JakeHafele101/Headnode/README.md

# Headnode

Headnode is in the battery pack and flips the relays to the battery pack as long as we are not in a fault state.
