JakeHafele101/Headnode/Documentation/Head Node Rev 1 Documentation.docx

Head Node

Project (P15) | Current Rev 5 | 7/12/2021 | Si Yuan Sim

HARdware Documentation

Si Yuan Sim

2021

Revision History
Rev # | Description | Hardware Manager | Approved By Need 2/3 for approval: eteam director or assistant director, eteam manager, or alumni
1 | 2021 ASC Rayce, reset for clarity | Si Yuan Sim


# Theory of Operation

## Description

Head node and module boards make up the Battery Protection System. Module boards gather data on pack operation and reports it back to head node. Using this data, array and pack interfaces are controlled. Most of the decision making and control is accomplished through the compute module on head node.

CAN is the primary digital communication protocol used in the car. The compute module CANH and CANL outputs are used for the main CAN bus. The pack network is looped through the modules and is terminated on one side at the end of the module board string. The other terminating resistor is located within Telem. This prevents the need for extra parts or different designs of module boards.

Module boards use a combination of software and hardware monitoring for voltage or temperature faults. The software monitoring and reporting is all handled using CAN as previously discussed. To get hardware fault information back to head node we have added an “Analog_Fault” line connecting each module. This line is normally high and is pulled low by a temperature or voltage fault on any module. The logical state of this line is used for array and pack interface decisions.

Head node is also in charge of the isolation and connection of the pack to the rest of the system that powers the car. Hence, whenever the car is turned on into safe state, to drive or to charge, head node would be responsible for its operation. This is accomplished by having several relay logic circuitry that would turn on the three large relays located within the battery box that are responsible for positive terminal of the pack, negative terminal of the pack and a relay designated for charging. During the turn on sequence, head node also controls the operation of Powerboard which is signified through a digital signal that the battery pack is in a safe state enabling Powerboard to switch from child board to the Vicors to power the critical, main and party lines. During driving, head node also sends a signal enabling Precharge to turn on another larger relay that connects the pack to the motor controllers allowing the motors to be driven.

## Board Placement

Head board will be placed on top of Precharge. They will draw power from Powerboard’s 12V critical line.

## Purpose

Lithium-ion batteries are quite volatile and by competition regulations require complex management systems. PrISUm Solar Car chooses to design and build their own management system over an off the shelf unit.

# Application

## System Level

### Block Diagram


Figure 1 Block diagram

### Pin Diagram

Connector | Connector Type | Pin Number | Connector Function
J1 | 2-Pin Megafit | 1 | Ground
| | 2 | 12V Critical from Powerboard
J2 | 2-Pin Minifit | 1 | Ground
| | 2 | Charge Relay Control
J4 | 2-Pin Minifit | 1 | Ground
| | 2 | Positive Relay Control
J5 | 2-Pin Minifit | 1 | Ground
| | 2 | Negative Relay Control
J3 | 4-Pin Minifit | 1,2 | Ground
| | 3 | Analog Fault Line Start
| | 4 | 12V Critical to Module Board
J13 | 2-Pin Minifit | 1 | Ground
| | 2 | Analog Fault Line End
J7 | 4-Pin Minifit | 1 | 12V Critical
| | 2 | Pack Hall Effect Sensor Reference
| | 3 | Pack Hall Effect Sensor Output
| | 4 | Ground
J9 | 4-Pin Minifit | 1 | 12V Critical
| | 2 | Array Hall Effect Sensor Reference
| | 3 | Array Hall Effect Sensor Output
| | 4 | Ground
J10 | 2-Pin Minifit | 1 | Precharge Drive Signal
| | 2 | Ground
J11 | 2-Pin Minifit | 1 | Powerboard Current Sense
| | 2 | Ground
J17 | 2-Pin Minifit | 1 | Powerboard Pack Start Signal
| | 2 | Ground
J15 | 2-Pin Minifit | 1 | External Kill Switch
| | 2 | Ground
J6, J8 | 2-Pin Minifit | 1 | CAN High
| | 2 | CAN Low
J12 | 4-Pin Minifit | 1,2,4 | Ground
| | 3 | Fan Control
J14 | 6-Pin Minifit | 1 | Array Switch
| | 2 | External Charge Switch
| | 3 | Array Relay
| | 4 | Ground
| | 5 | Tracker Enable
| | 6 | External Charge Enable

### VDR Requirements

5.2.E.3 – Over Temperature Set Points

Battery State | Low(˚C) | High(˚C)
Charge | 10˚C | 45 ˚C
Discharge | -20 ˚C | *60 ˚C

*Monitored by hardware. All others in software

5.2.E.4, 5.2.E.5 – Under and Over Voltage Set Points

Battery Module Voltage Warnings and Limits

Type | Trip Point (Volts) | Hardware Monitored | Software Monitored
Voltage Low Warning | 3.0V | | x
Voltage Low Fault | 2.8V | X | x
Voltage High Warning | 4.0V | | x
Voltage High Fault | 4.2V | X | x

5.2.E.6 – Over Current Set Points

Pack Current Limits for Charge and Discharge

Battery State | Current Limit
Charge | 40.0A
Discharge | -50.0A

5.2.E.8 – Start-up and Fault Handling

When the start process for the car has been initiated by flipping the main switch. The Auxiliary Line will power BPS and critical systems. At this point Head Node will begin polling each individual module through CAN, checking for continuity, voltage measurements and temperature measurements for any faults. If all modules report OK, then the start-up process continues by allowing our Precharge and Powerboard systems to provide power to the rest of the car and close the relays connecting the main pack to the rest of the electrical systems within the car.

The job of every Module Board is to record and report data back to Head Node. When a fault occurs in a battery module, it will be reported by hardware back to a digital kill circuit on Head Node which will open the relays. It will also be recorded by software and reported over the CAN bus to active the BPS strobe and driver fault indicator.

5.2.E.9 – Static Firmware

In order to comply with Regulation 8.4F BPS software must be unmodified after scrutineering and tamper proofing must be implemented. Head node has header pins used to program the microcontroller using JTAG standards. These pins will be covered in taper proof tape and signed by the scrutineer. This will prevent the modification of software on any head node.

5.2.E.10 – Driver Dash and BPS Strobe

The fault CAN message reported by BPS will be picked up by Rear Hal and activate the BPS Strobe. The same message will also be picked up by the driver display and indicates to the driver a BPS fault occurred. When the relays are open HAL, BPS, and Driver Dash are powered by an auxiliary pack.

## Board Level

### Power Supplies

Power for Head node and module boards is supplied by 12V_Crit from Powerboard. This is regulated down to 5V using an NCP1117 linear regulator. This part has the DPAK packaging to handle the thermal load of the large voltage drop. A linear regulator was chosen over a switching type due to the ease of implementation. In the future, a good modification to the board would be to replace this linear regulator. Recom makes integrated modules that are easy to use. For the more ambitious, a custom layout can be done using any switching controller. The regulator is 1A capable, but Head Node only requires ~30mA to operate in normal conditions.

As mentioned above, thermal considerations are an important factor in linear regulator choice. The DPAK version of this part has a maximum Die Junction Temperature of 150C. As can be seen in the following equations, the regulator should comfortably handle the load.

P_d =I_(Load) *(Vin-Vout)=30mA*(12V-5V)=210mW

T_(Rise) =R_(theta) *P_D =(67C)/W*210mW=14.07C

The drawback with this design is the poor efficiency. But it is easy, has only 3 parts, and stays cool so it should not cause any problems. There is also another reference providing a 2.5V reference but this is outdated which was intended for a different hall effect sensor than the one we are using currently.

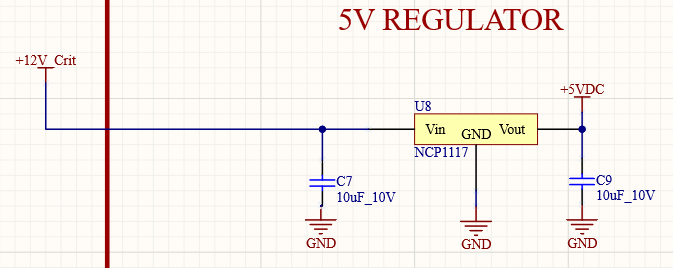
[picture p15: figure]

Figure 2 5V Linear regulator circuitry

### Analog Fault Line

The analog fault line is provided by head node to the first module board in the chain. It is a 5V signal and a jumper resistor was used as a test and can be taken off for future purposes.

Figure 3 Analog fault line start

To receive the analog fault line from the 35th module board, which is the module board at the very end, a buffer circuit is required. This is because the line from the back of the network is very long and there might be considerable losses resulting in a very weak signal. Hence, a BJT was used to buffer it which uses a common collector topology. When the analog fault line is high, it drives the body diode between the base and emitter turning the BJT on. Conversely, it would turn off when the analog fault line goes low. This signal is fed to the MCU as well as the logic interface hardware. This gives us both hardware and software redundancies making the system even safer.

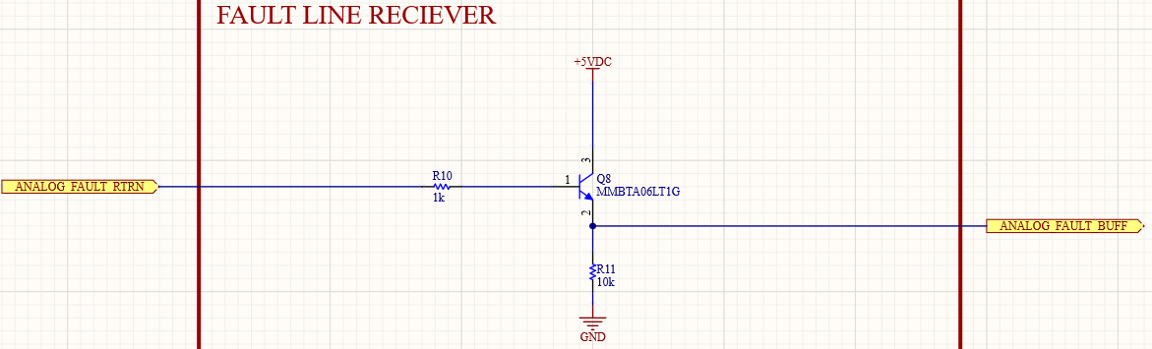
[picture p16: figure]

Figure 4 Analog fault line receive circuit

### External Kill

According to regulations, the car must possess an external kill switch that can be accessed from the outside of the car. This switch should allow for any person to immediately shut down the system and isolate the battery pack in case of an emergency. The switch is connected to a 2-pin minifit connector, and it is typically closed in a normal state. This would pull the uC_EXT_KILL node low giving it a digital signal of 0. To shut down the car immediately, the switch would need to be flipped to the open state causing the node to be pulled up to 5V through a 10kΩ resistor. This was done with the fact in mind that the connectors coming loose would also act as an open switch pulling the node up. It would prevent us from driving without any knowledge that the external kill switch is no longer working.


Figure 5 External kill

### Reverse Polarity and Fuse Blown Circuit

To protect the board from human error if a connector were to be plugged in reverse, a reverse polarity diode is used. This requires a simple P-channel MOSFET where the gate is connected to ground and the source and drain acting as the typical conducting path. In a normal case where the connector is plugged in correctly, the gate would be ground at 0V, and the source would be at 12V. This would have a gate-to-source voltage of -12V turning the MOSFET on thereby powering the entire board. However, if it were to be reversed, the gate-to-source voltage would instead be 12V which would disable the component preventing any other part in the circuit to be destroyed.

The fuse would protect the board from any excessive current draw, and it is set to less than 5A currently due to the current draw from the large relays in the battery box. This might not prevent any components from being destroyed however it would stop it from burning or blowing up as it would cut off the supply. Once again, a P-Fet is used as a good fuse would conduct the 12V to the gate causing the gate-to-source voltage to be 0V turning it off. However, burning the fuse would mean a -12V gate-to-source voltage which would cause the P-Fet to conduct and draw current into a resistor through the 12V supply and current limited by a 1kΩ resistor.

A TVS diode is also used for any high voltage transient suppression (ESD). However, a Zener diode should also be looked into in the future as a clamping mechanism as ESD is typically not as much of a concern for many of our purposes whereas over-voltages happen a lot more regularly within this team.

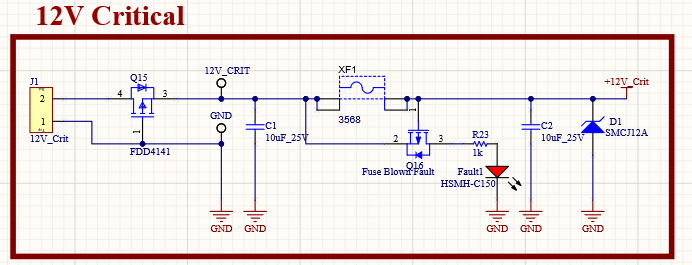
[picture p17: figure]

Figure 6 Reverse protection and fuse blown circuit

### Hardware Interface Logic

The logic that controls much of the operation of head node is located in this circuit. Three AND gates within the same package are used that controls three aspects that are: turning on the car, enabling array charging and enabling external charging. However, external charging has a different implementation, and the current circuit is a leftover remnant from Penumbra’s head node. This includes both circuits in Figure 7 and Figure 8.

For the turn-on operation, three signals are required to turn on the AND gate which produces a high signal (START_EN) that propagates to the three logic circuits that would control the operation of the three large relays within the battery box for positive terminal, negative terminal and external charging. The three signals required are:

1. ANALOG_FAULT_BUFFER – Analog fault line
2. uC_Fault_F – Software controlled fault signal
3. uC_EXT_KILL – External kill switch which defaults to 0 as “good” which is why an inverter is used to turn on the AND gate.

As for the array and external charge logic, as mentioned earlier, this external charge logic is now irrelevant, but the array charge logic remains the same. Similar to the battery pack turn on logic, three signals are also needed, one software fault signal, one hardware and one software switch enable lines for redundancies. They are specifically:

1. uC_Fault_F – Software controlled fault signal
2. ARRAY_EN – Software controlled array enable signal
3. ARRAY_SW – Hardware controlled array enable signal

The output of this AND gate signal for arrays would then be XORed with the same exact logic circuit for external circuit (not in use). This means that if the ARRAY_TRIGGER signal were to be high, array charging will always be enabled since this external charge logic is disabled. Hence, in order to ensure that both external charge and arrays are not enabled at the same time (since external charge is controlled in a separate logic), software has to be written in order to ensure that only one of the functions are on at the same time.

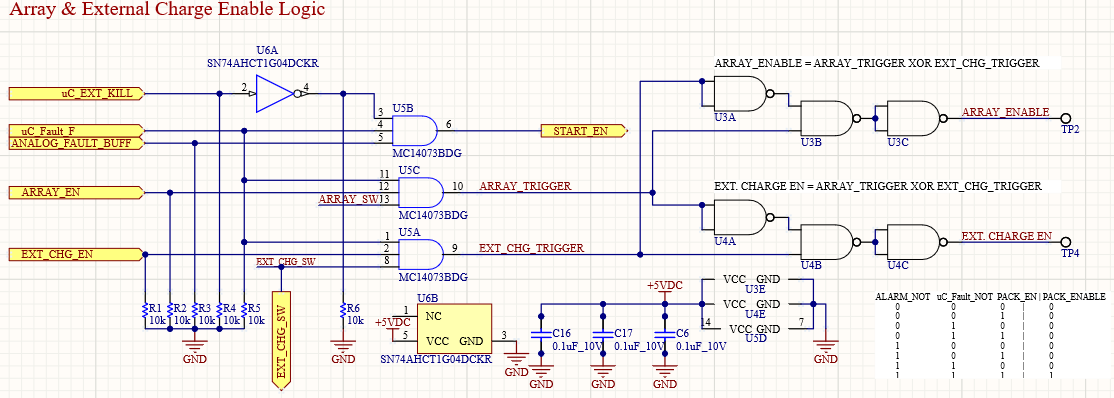
[picture p18: figure]

Figure 7 Hardware interface logic

### Array Interface

As mentioned earlier, the external charging interface here is outdated but is still in use for arrays. The two MOS circuits on the right are the switch circuits that lead to the AND gate logic earlier. N-channel MOSFETs are used since if the switch were closed and connected to ground, that would mean the device is turned off and connected to ground propagating a high signal. Conversely, if the switch were to be opened, the gate is connected up to 5V turning the device on and connecting the ARRAY_SW node to ground. This has similar intent to the external kill logic since a disconnecting connector would not artificially induce a high signal but instead kill the entire charging operation which would alert users appropriately.

The circuits on the left side on the figure instead are used to control signals that are sent out of the board to their respectively destinations. After fulfilling all the conditions necessary, the N-channel MOSFETs are turned on causing them to propagate a low signal.


Figure 8 Array and external charge interface

### Relay Logic

The large relays within the battery box that are not installed on any battery box are driven by the control relay logic housed on head node. There are two stages that control its operation. The first stage is a two input AND gate that turns on either a relay or a power switch that is used to drive the larger off board relays (Figure 9). For this revision, the semiconductor shortage prevented us from obtaining the power switches hence for the car, Eliana, the primary way of turning the large relays will be through the smaller onboard relays. A 0Ω jumper resistor is used to switch between the two methods of driving and only one method should be used at any given moment. This is to prevent any conflicts between the two electrical components as one could be shunting current into the other thereby burning both components.

The second stage involves either using a relay to shunt current into the larger relay or through a power switch. We will be explaining the relay method first in Figure 10. There is a need to buffer the 5V digital signal from the two input AND gate to 12V as the linear regulator used on head node is not sufficient to supply both the smaller relay and the large relay. The onboard relays are OMRON G5CA-1A 12V which means it has a 12V coil rating. Theoretically, we should be able to just use a 5V control signal to turn on a relay to shunt 12V to the larger relays, however through extensive testing, it was found that the MOSFET that allows for current to flow into the coil of the current tends to burn which shows that more current is being drawn than expected. The same is true for the large relays which have a peak instantaneous current draw of 3A. Hence, both the large and small relays are being drawn of 12V Critical from Powerboard which has such capabilities. The buffer circuit works through this process:

1. If the gate voltage of Q6 (or Q10 and Q12) is 5V, it will cause the gate of Q9 (or Q11 and Q13) to be pulled to ground turning it on.
2. This means that current would flow through the coil of the OMRON relay which will generate a magnetic field pulling the contacts shut.
3. Current is shunted directly from 12V Critical to the large off board relays.
4. The opposite happens is the digital input at the beginning

Note the use of the diode that is connected across the coil of each OMRON relay. This is a flyback diode which is used to discharge the energy stored in the coil (acting as an inductor). This prevents any reverse voltage across the P-channel MOSFET which would damage it and cause unexpected behaviors.


Figure 9 Control logic to turn on onboard relays

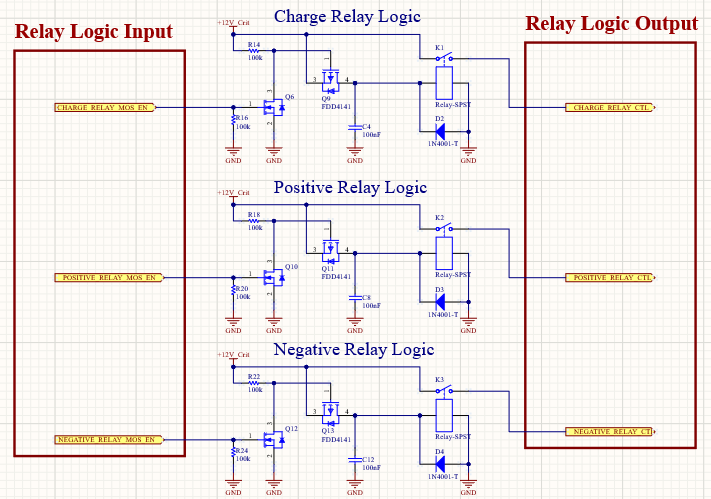
[picture p19: figure]

Figure 10 Relays to turn on larger battery box relays

### Current Sense

Another aspect of head node is sensing the current that is flowing from the arrays into the pack as well as the current that is being used by the motor controllers to power the motors. To achieve this, hall effect sensors from Honeywell are used, CSLA2DG. These sensors can sense both AC and DC current which is ideal since regen would also send power back to the pack which would be useful information to obtain. They also run on 12V Critical supplied by head node and output 6V at 0A nominally. However, it was found that there are quite large differences between different components, and they need to be characterized in order to have an accurate read.

The characterization process includes looping a wire around the hall effect sensor multiple times in order to artificially generate a larger magnetic field which we can translate into a large current. This is because the bench power supplies can only generally reach up to 5A and it is an easy way to know the current flowing through the wire. Through testing, it was found that a looping a wire around just once would double the “current” compared to a straight wire just going through the middle of the hall effect. Hence the equation to generalize the current would be:

Theoretical output current=(Number of loops+1)*Actual supply current

The characterization for one of the hall effect sensor used can be found in Figure 11 and it can be seen that it is extremely linear. But the downside of this hall effect sensor is that its maximum current sense is at 150A which is double our maximum expected output at 80A. This means that we would be unable to full advantage of the resolution of the ADC on the MCU on S+. This was caused by a lack of supply for the other models. Another note is that there is a need to subdivide down the output voltage from 12V (max) to 5V (MCU voltage) to prevent burning an S+. This was accomplished by a simple voltage divider with a ratio of 5/12.


Figure 11 Linear regression model of hall effect sensor

### Precharge and Powerboard Interface

Precharge and powerboard propagate a signal from the MCU on compute which is then buffered using two different circuits. Powerboard requires a 12V signal hence the same circuit used on the previous relay buffer is also used here and it operates the same. The precharge buffer on the other hand uses a BJT in a common collector configuration. A high signal drives the body diode of the BJT between the base and emitter turning the component on drawing current from the collector to the emitter which would drive the signal across a wire to precharge which is located below head node.

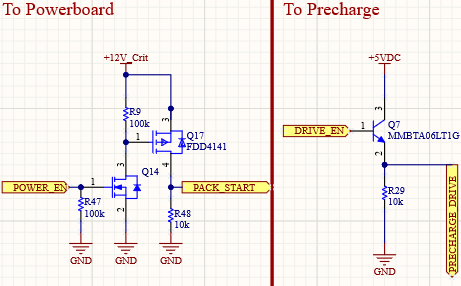
[picture p20: figure]

Figure 12 Precharge and powerboard interface

### Power Switches

The power switches from Infineon were not able to be ordered hence it could not be tested. However, the part was very simple according to its datasheet with no decoupling necessary and only a 10kΩ current limiting resistor was required to turn on at the enable line. This would protect the MCU during overvoltage and during reverse battery condition. The current sense was also going to be ignored on this board since there is a limit on the number of analog input pins and there is no big need to measure these currents. But the resistor values used were suggested by the manufacturer. The output current is determined the sense resistor which is 1kΩ with the 10kΩ resistor being used for protection. The current sense output would be a current which is determined using the equation below.

I_(IS) =((I_L)/(k_(IS)))+I_(IS(OFFSET))

k_(IS) =(I_(L1) -I_(L2))/(I_(IS) (I_(L1) )-I_(IS) (I_(L2) ))

I_(IS(OFFSET)) =50uA min, 240uA typical and 600uA max


Figure 13 Power switches to turn on large off board relays

### PCB Picture

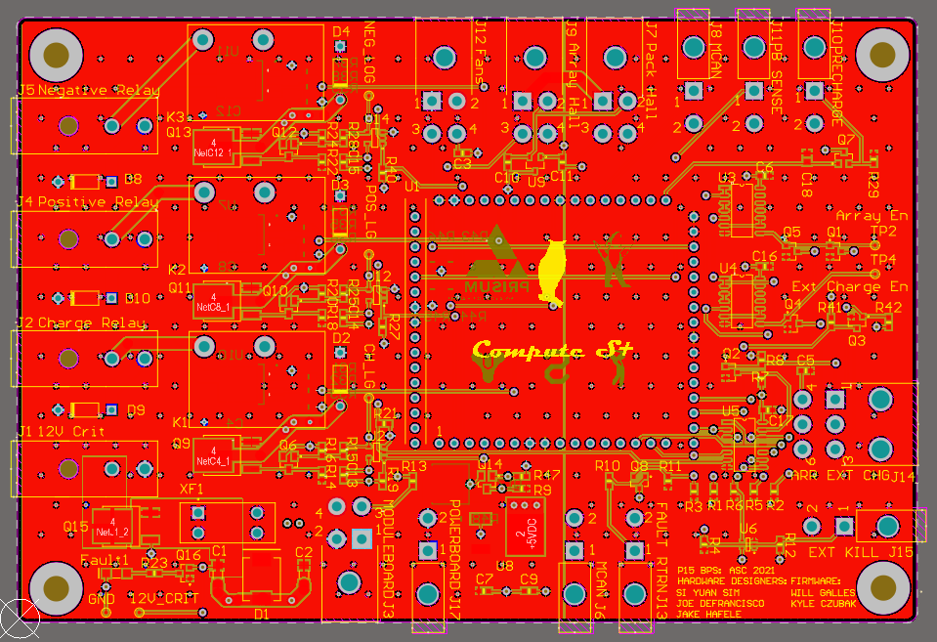
[picture p21: figure]

Figure 14 PCB layout of head node

Head node was laid out with the intention to divide the PCB into two parts to accommodate a 12V domain (left) and a 5V digital domain (right). It also uses four layers with the middle two layers being a 5V plane and a solid intact ground plane. The top and bottom layer for the left side (12V domain) is a 12V plane which is stitched together using stitching vias which would allow for maximum current to be shunted to the necessary outputs. This left side basically consists of the relays as well as its supporting logic to turn them on.

The right side on the other hand consists of all the digital logic operating at 5V. This includes the hardware interfacing logic as well as the other circuits operating at 5V. The bottom and top layers are covered by a ground plane which would isolate the noise produced by digital circuits during high speed switching.

# Proof of Operation

## Test Procedure

1. Test 12V and 5V rails
  a. Connect J1 to a 12V source and measure the test point 12V_Crit to check if power propagated across the fuse.
  b. Check the right large tab on U8 and ensure that it is outputting 5V.
2. Check turn on logic
  a. Provide 5V to pin 1 of J13 which is the analog fault return line.
  b. Short J15 (external kill) across each other to ground.
  c. Provide 5V to the pin PA13 at the compute using a supply.
  d. Measure pin 6 of U5 (second from bottom left) and ensure it is high at 5V.
  e. Remove each of the above inputs and check pin 6 once again and ensure that it turns low.
3. Check turn on for relays
  a. Keep the above signals high
  b. Provide 5V to PA9, PA10 and PA11 each and wait for a click sound from the relay which symbolizes that the contacts closed
  c. Otherwise, check the test points CH_LG, POS_LG and NEG_LG and check if they went high
  d. If they went high and no clicking sounds can be heard from the relays, there is most likely an issue with the buffer.
  e. If they went low instead, there might be an issue with the AND gate.
4. Check output buffers for Powerboard and Precharge
  a. For precharge, give pin PA27 on the compute pin 5V and check pin 1 of J10 and check for 5V.
  b. For powerboard, give pin PB10 on the compute pin 5V and check pin 1 of J17 and check for 12V.
  c. In either case, if both are not giving the expected outputs, ensure that the correct MOSFETs are used with the correct type.

## Test Results

The board works as intended accordingly as explained in the project details.

## Troubleshooting

1. A common issue found was that the digital logic gates were easily overloaded if too small values of pulldown resistors were used. This would draw out too much current from the AND gates preventing a strong pull to the 5V rails for a high signal.
2. Due to the mix match of transistors used in this circuit, if anything is behaving unexpectedly, it would be significantly easier to isolate the cause to a particular circuit and start unsoldering one transistor after another and testing if the remaining transistor on board works. It is unadvised to reuse transistors.
3. If it is suspected wrong transistors were put on, it is much easier to just put on a new one that it is known that it is of the correct type as it is hard to attempt to figure the type of transistor as well as its chemistry.

## Future Considerations

1. The power switches should replace the relay circuitry as the relay circuitry uses a constant 16mA each for a total of 48mA when all three are turned on just to run these small onboard relays. Using the power switches would reduce the power expenditure to only the large offboard relays which is unavoidable. This would further increase the efficiency of the car.
2. Remove old external charging interface in the Interface schematic page as it is outdated. Think of hardware redundancy to prevent both the turn on of array and external charging. Could use XOR gate circuit which is pretty straight forward.

# Additional Resources

## PrISUm Contacts

Name | ISU Email | Personal Email | Phone
Si Yuan Sim | simsy@iastate.edu | simsiyuan@gmail.com | 515-2008140
Joe DeFrancisco | joedef@iastate.edu | - | 515-8228289

# Appendix

## BOM List

Check the P15_BPS repository in Prisum’s Github account.
