JakeHafele101/Headnode/BOM/BPS_REV2_BOM.xlsx

General Part | PCB Label | Custom Reference | Manufacturer Number | Retailer Number | Package Size | Value | Retailer Link | Amount Per Board | Cost per unit | Amount Per Order | Cost Per Order Per Part | Board Name: | Headnode
12V Zener | D1 | Headnode D1 | SMCJ12A | SMCJ12ALFCT-ND |  |  | https://www.digikey.com/en/products/detail/littelfuse-inc/SMCJ12A/762376 | 2 | $0.58 | 6 | $3.48 | Number of Boards: | 3
Rectifier Diode | D2, D3, D4, D5 | Headnode D2, D3, D4, D5 | 1N4001-T | 1N4001DICT-ND |  |  | https://www.digikey.com/en/products/detail/diodes-incorporated/1N4001-T/601 | 5 | $0.58 | 15 | $8.70
Red LED | Fault1 | Headnode Fault1 | HSMH-C150 | 516-1439-1-ND | 1206 |  | https://www.digikey.com/en/products/detail/broadcom-limited/HSMH-C150/637700 | 2 | $0.48 | 6 | $2.88 | Total cost: | $209.19
10 uF 16V Cap | C1 | Headnode C1 | CL31A106MOHNNNE | 1276-2877-2-ND | 1206 | 10 uF 16V | https://www.digikey.com/en/products/detail/samsung-electro-mechanics/CL31A106MOHNNNE/3888535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 | 2 | $0.28 | 6 | $1.68
1 uF 16V Cap | C2 | Headnode C2 | CL31F105ZOCNNNC | 1276-2857-2-ND | 1206 | 1 uF 16V | https://www.digikey.com/en/products/detail/samsung-electro-mechanics/CL31F105ZOCNNNC/3888515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 | 2 | $0.00 | 6 | $0.00
0.1 uF 50V Cap | C9 | Headnode C9 | 08055C104JAT2A | 478-3352-2-ND | 805 | 0.1 uF 50V | https://www.digikey.com/en/products/detail/kyocera-avx/08055C104JAT2A/929984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 | 2 | $0.18 | 6 | $1.08
10 nF 100V Cap | C3, C5, C6, C7, C10, C11, C13, C14, C15, C16, C17 | Headnode C3, C5, C6, C7, C10, C11, C13, C14, C15, C16, C17 | CGA3E2X8R2A103K080AD | 445-8825-2-ND | 603 | 10 nF 100V | https://www.digikey.com/en/products/detail/tdk-corporation/CGA3E2X8R2A103K080AD/3248155 | 15 | $0.25 | 45 | $11.25
10 pF 50V Cap | C8, C12 | Headnode C8, C12 | C0805C100G5GACTU | 399-C0805C100G5GAC7800TR-ND | 805 | 10 pF 50V | https://www.digikey.com/en/products/detail/kemet/C0805C100G5GAC7800/12701157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 | 3 | $0.00 | 9 | $0.00
Inverter | U6 | Headnode U6 | SN74AHCT1G04DCKR | 296-4706-1-ND |  |  | https://www.digikey.com/en/products/detail/texas-instruments/SN74AHCT1G04DCKR/376059 | 2 | $0.38 | 6 | $2.28
3 Channel 3 Input AND | U4, U5 | Headnode U4, U5 | MC14073BDG | MC14073BDGOS-ND |  |  | https://www.digikey.com/en/products/detail/on-semiconductor/MC14073BDG/1478796 | 3 | $0.46 | 9 | $4.14
Quad Channel 2 Input NAND | U3 | Headnode U3 | 74AC00SCX | 74AC00SCXCT-ND |  |  | http://www.digikey.com/product-detail/en/fairchild-semiconductor/74AC00SCX/74AC00SCXCT-ND/1626130 | 2 | $0.63 | 6 | $3.78
PMOS | Q15 | Headnode Q15 | FDD4141 | FDD4141CT-ND |  |  | https://www.digikey.com/en/products/detail/on-semiconductor/FDD4141/1658354 | 2 | $1.05 | 6 | $6.30
NMOS | Q1, Q2, Q3, Q4, Q5, Q6 | Headnode Q1, Q2, Q3, Q4, Q5, Q6 | MGSF1N03LT1G | MGSF1N03LT1GOSCT-ND |  |  | https://www.digikey.com/en/products/detail/on-semiconductor/MGSF1N03LT1G/919443 | 10 | $0.47 | 30 | $14.10
PMOS | Q16 | Headnode Q16 | IRLML6402TRPBF | IRLML6402PbF |  |  | https://www.digikey.com/en/products/detail/infineon-technologies/IRLML6402TRPBF/811437 | 2 | $0.55 | 6 | $3.30
High Side Switch | U7, U10, U11 | Headnode U7, U10, U11 | BTF500601TEAAUMA1 | BTF500601TEAAUMA1TR-ND |  |  | https://www.digikey.com/en/products/detail/infineon-technologies/BTF500601TEAAUMA1/2523005 | 3 | $4.81 | 9 | $43.29
1k Res | R10, R12, R33, R36, R39 | Headnode R10, R12, R33, R36, R39 | RC0603FR-071KL | 311-1.00KHRCT-ND | 603 | 1k | https://www.digikey.com/en/products/detail/yageo/RC0603FR-071KL/726843 | 10 | $0.10 | 30 | $3.00
10k Res | R1, R2, R3, R4, R5, R6, R7, R8, R9, R11, R12, R14, R15, R16, R17, R18 R19, R21, R27, R31, R32, R34, R35, R37, R38, R40 | Headnode R1, R2, R3, R4, R5, R6, R7, R8, R9, R11, R12, R14, R15, R16, R17, R18 R19, R21, R27, R31, R32, R34, R35, R37, R38, R40 | RC0603FR-0710KL | 311-10.0KHRCT-ND | 603 | 10k | https://www.digikey.com/en/products/detail/yageo/RC0603FR-0710KL/726880 | 40 | $0.10 | 120 | $12.00
Ferrite Bead | FB1 | Headnode FB1 | HI1206N800R-10 | 240-2409-2-ND | 1206 | 80 Ohm | https://www.digikey.com/en/products/detail/laird-signal-integrity-products/HI1206N800R-10/806646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 | 3 | $0.10 | 9 | $0.90
5V Switching Reg | U2 | Headnode U2 | R-78AA5.0-1.0SMD-R | 945-1044-2-ND |  |  | https://www.digikey.com/en/products/detail/recom-power/R-78AA5-0-1-0SMD-R/2256224 | 1 | $9.84 | 3 | $29.52
2 Pin Minifit | J6, J8, J10, J11, J13, J15, J17 | Headnode J6, J8, J10, J11, J13, J15, J17 | 39300020 | WM21351-ND |  |  | https://www.digikey.com/en/products/detail/molex/0039300020/930320?s=N4IgTCBcDaIAxwMwE5ELmOIC6BfIA | 10 | $0.66 | 30 | $19.80
4 pin Minifit | J3, J7, J9, J12 | Headnode J3, J7, J9, J12 | 39301040 | WM1352-ND |  |  | https://www.digikey.com/en/products/detail/molex/0039301040/561079 | 5 | $0.75 | 15 | $11.25
6 Pin Minifit | J14 | Headnode J14 | 39301060 | WM1352-ND |  |  | https://www.digikey.com/en/products/detail/molex/0039301040/561079?s=N4IgTCBcDaIOoFkCMBmArGAtAOQCIgF0BfIA | 2 | $0.85 | 6 | $5.10
2 Pin Megafit | J2, J4, J5 | Headnode J2, J4, J5 | 768250002 | WM11969-ND |  |  | https://www.digikey.lt/product-detail/en/molex/0768250002/WM11969-ND/5639611 | 4 | $1.14 | 12 | $13.68
Blade Fuse Holder | F1 | Headnode F1 | 3568 | 36-3568-ND |  |  | https://www.digikey.com/en/products/detail/keystone-electronics/3568/2137306 | 2 | $1.28 | 6 | $7.68
