JakeHafele101/Headnode/Altium Project/Headnode.pdf

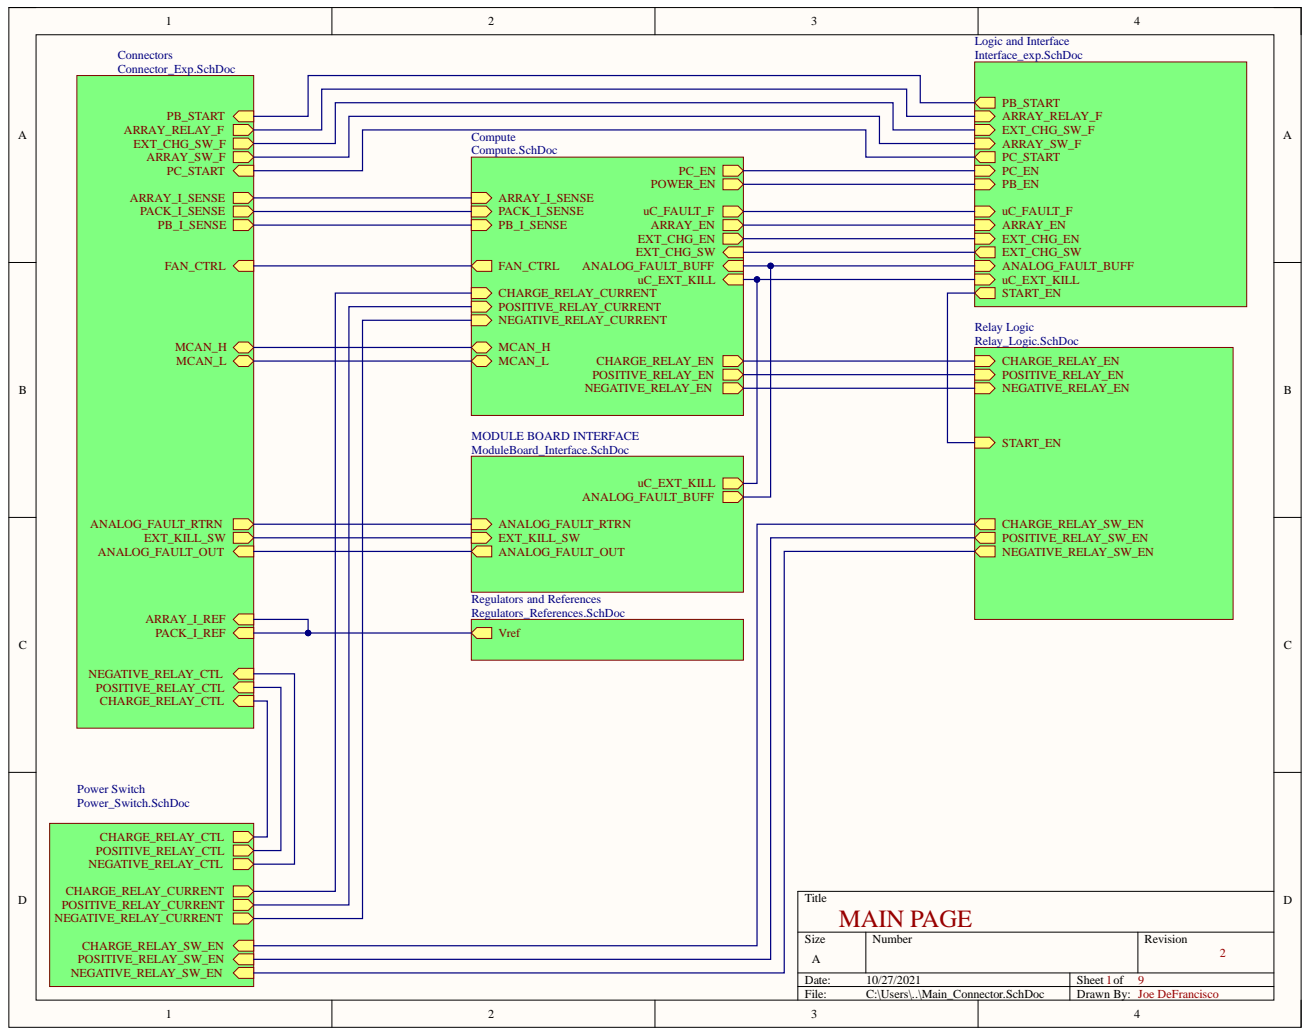
[picture p22: page 1]

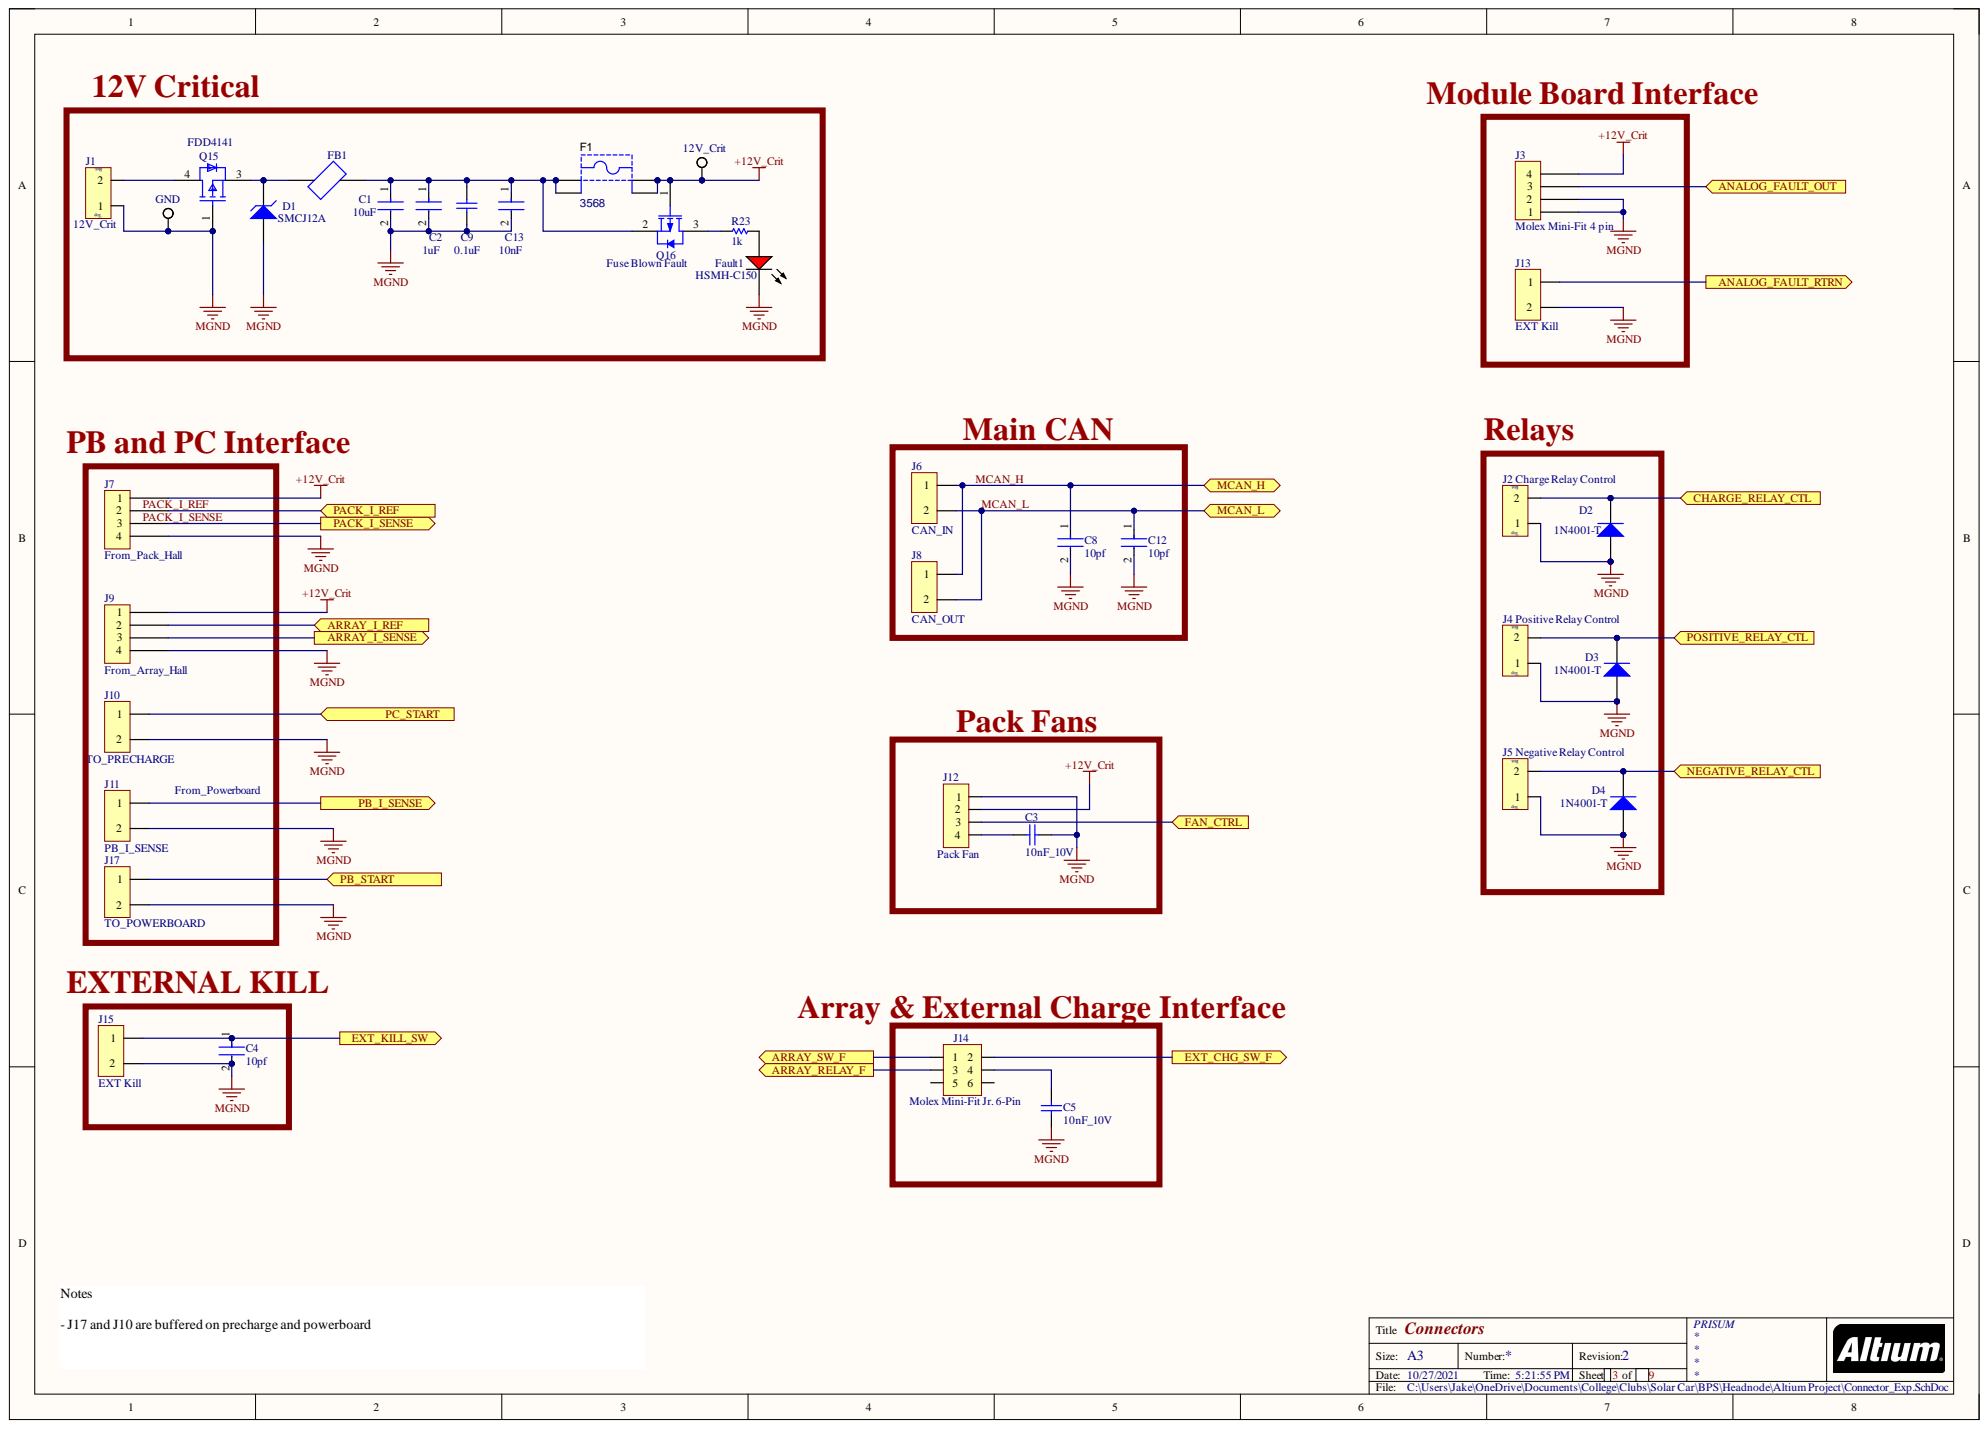
[picture p23: page 2]

PB and PC Interface

Array & External Charge Interface

Molex Mini-Fit Jr. 6-Pin

-J17 and J10 are buffered on precharge and powerboard

C:\Users\Jake\OneDrive\Documents\College\Clubs\Solar Car\BPS\Headnode\Altium Project\Connector_Exp.SchDoc

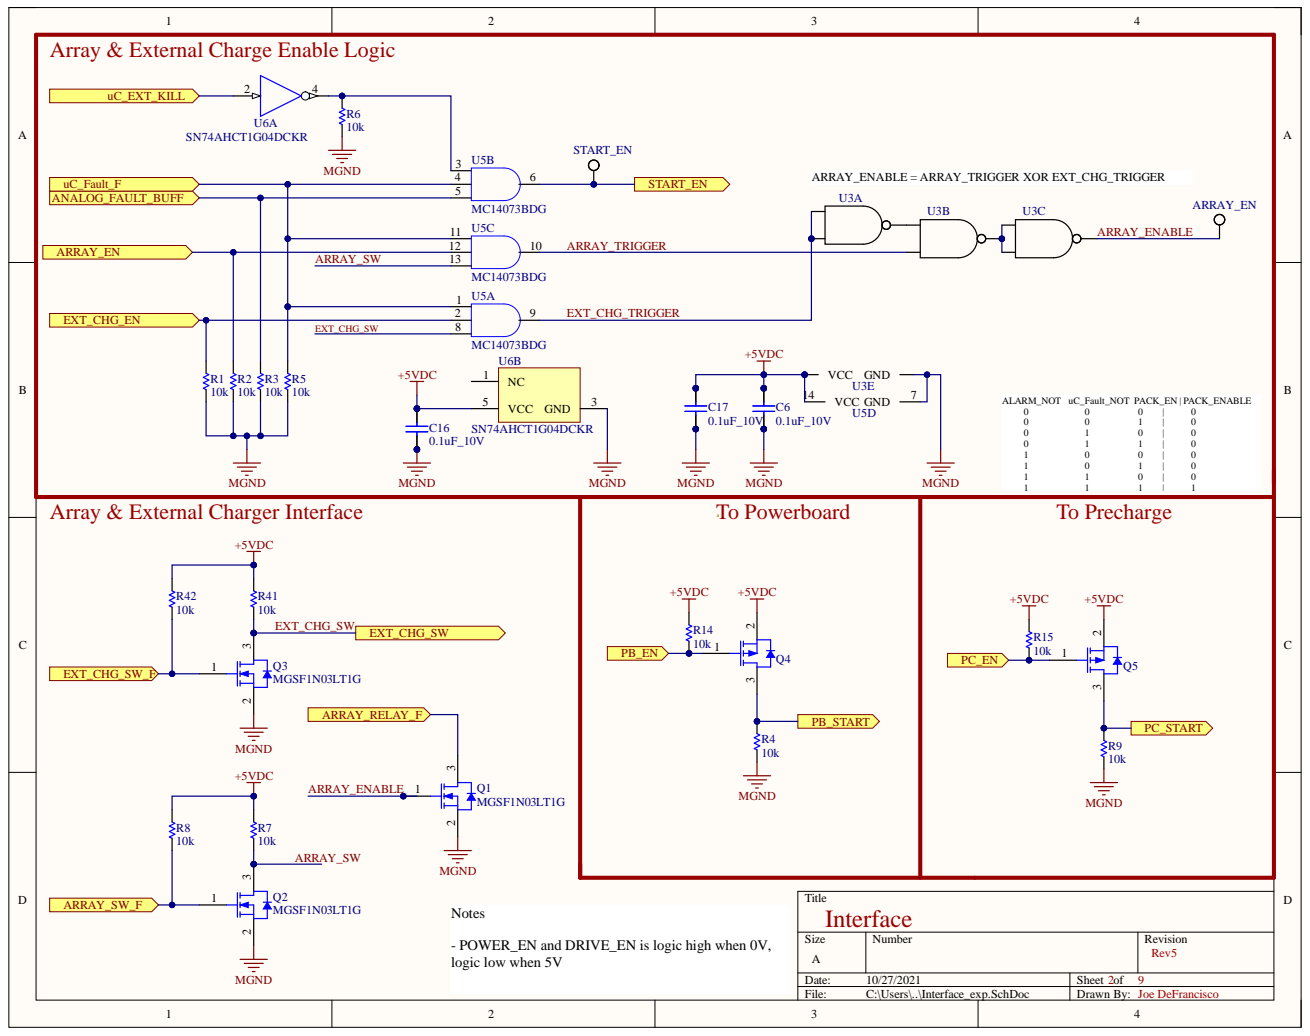
[picture p24: page 3]

Array & External Charge Enable Logic

Array & External Charger Interface

- POWER_EN and DRIVE_EN is logic high when 0V,
logic low when 5V

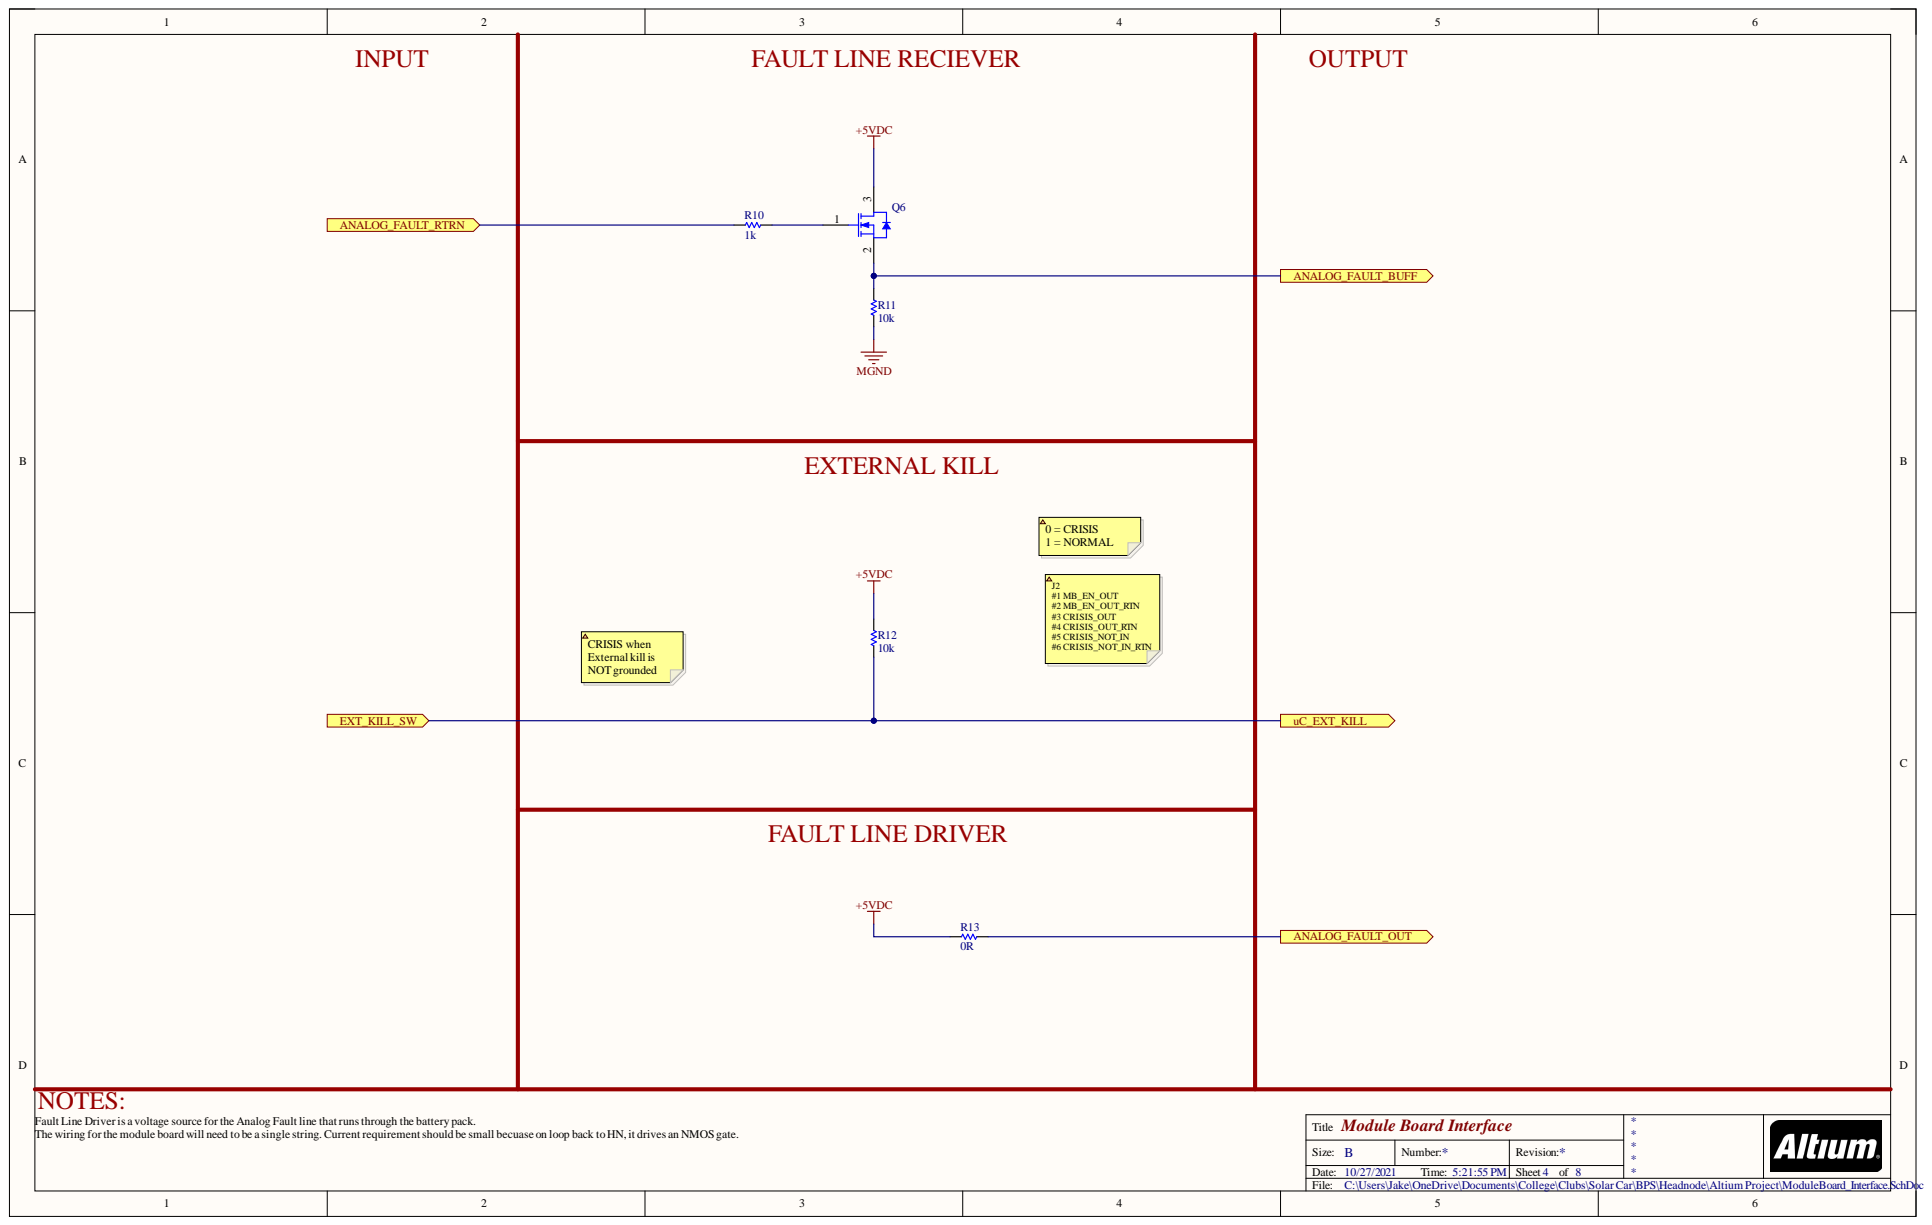
[picture p25: page 4]

FAULT LINE RECIEVER +5VDC

Fault Line Driveris a voltage source forthe Analog Fault line thatrunsthrough the battery pack.
The wiring forthe module board will need to be a single string. Currentrequirementshould be small becuase on loop back to HN, it drives an NMOS gate.

Title Module Board Interface | * * * * *

Size: B | Number: * | Revision: *
Date: 10/27/2021 Time: 5:21:55 PM | | Sheet 4 of 8

C:\Users\Jake\OneDrive\Documents\College\Clubs\SolarCar\BPS\Headnode\Altium Project\ModuleBoard_Interface.SchDoc

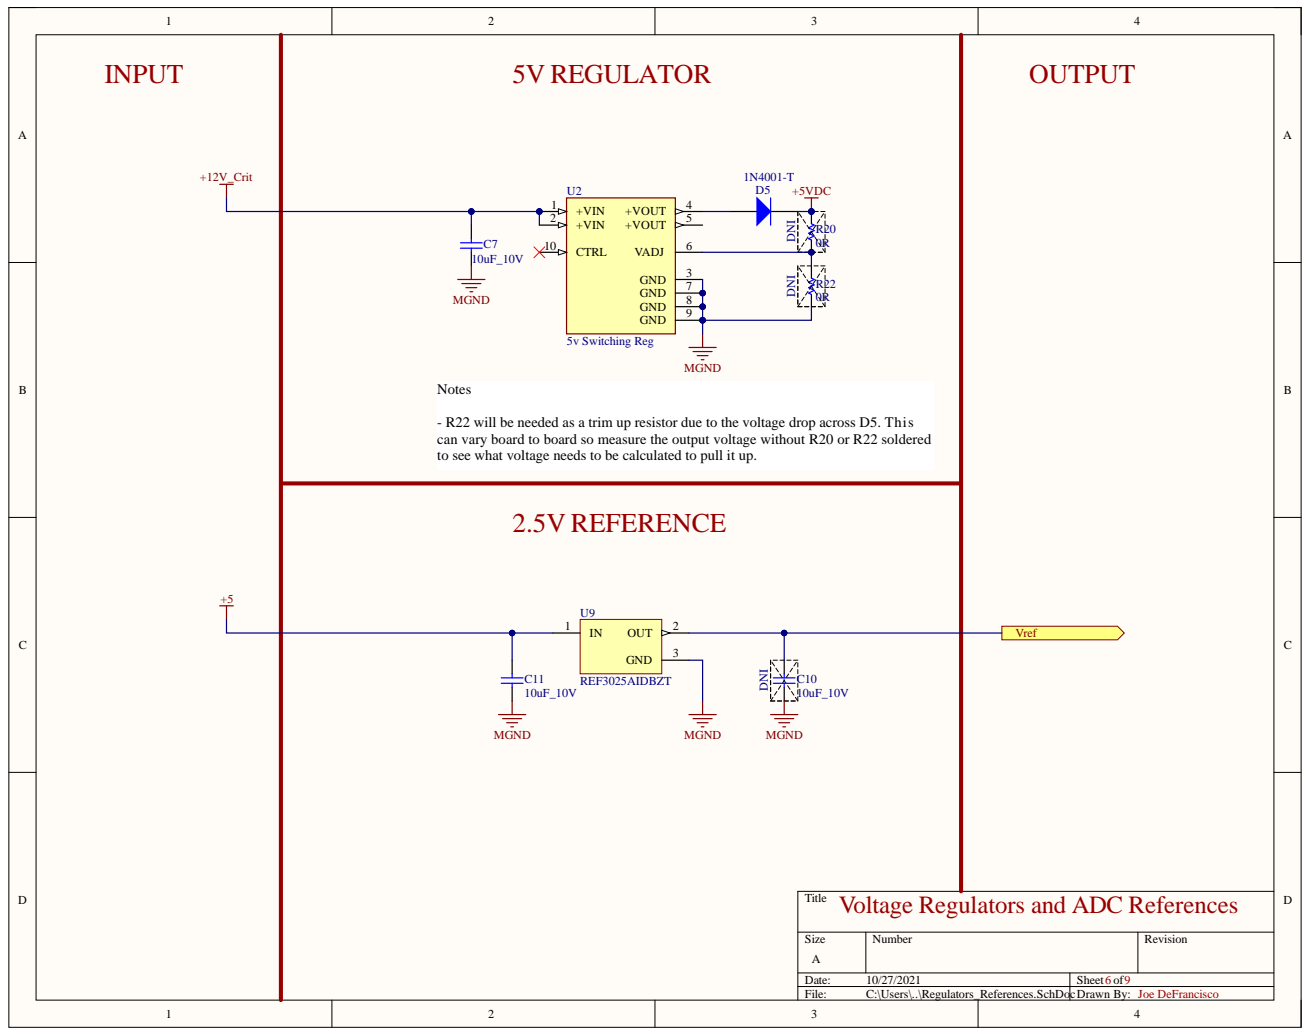
[picture p26: page 5]

- R22 will be needed as a trim up resistor due to the voltage drop across D5. This
can vary board to board so measure the output voltage without R20 or R22 soldered
to see what voltage needs to be calculated to pull it up.

Title
Voltage Regulators and ADC References

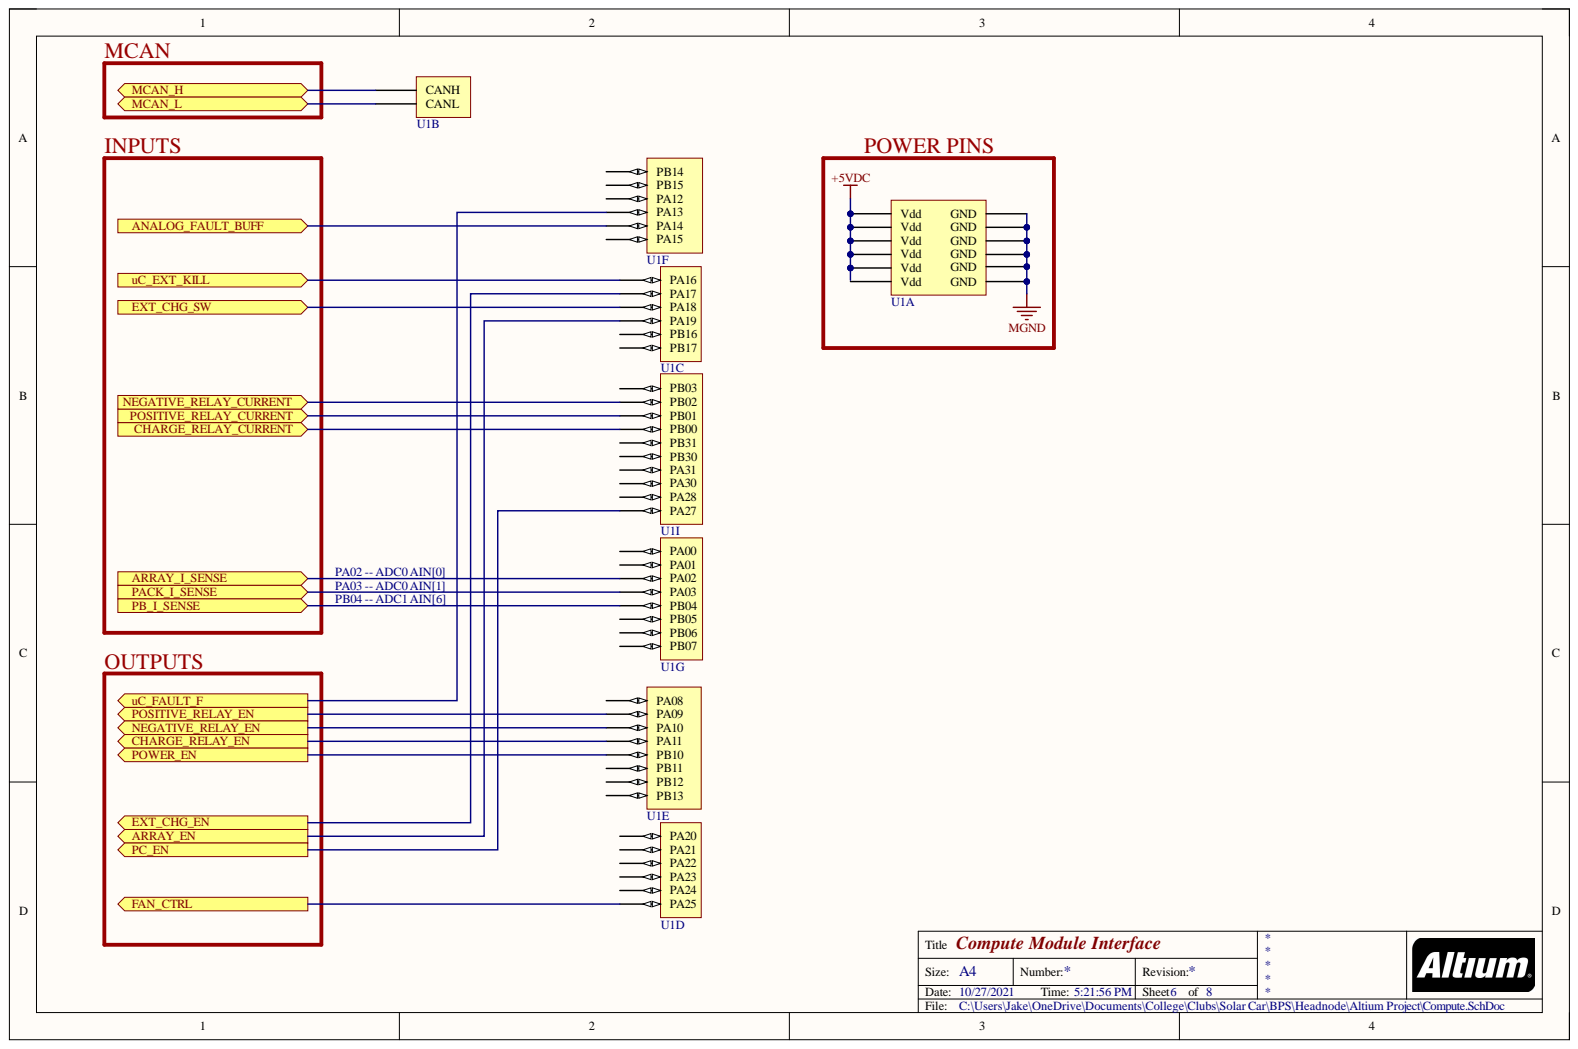
[picture p27: page 6]

PA02 -- ADC0 AIN[0]
PA03 -- ADC0 AIN[1]
PB04 -- ADC1 AIN[6]

Compute Module Interface Title | * * * * *

Size: A4 | Number: * | Revision: *

Date: 10/27/2021 Time: 5:21:56 PM | | Sheet 6 of 8

C:\Users\Jake\OneDrive\Documents\College\Clubs\Solar Car\BPS\Headnode\Altium Project\Compute.SchDoc

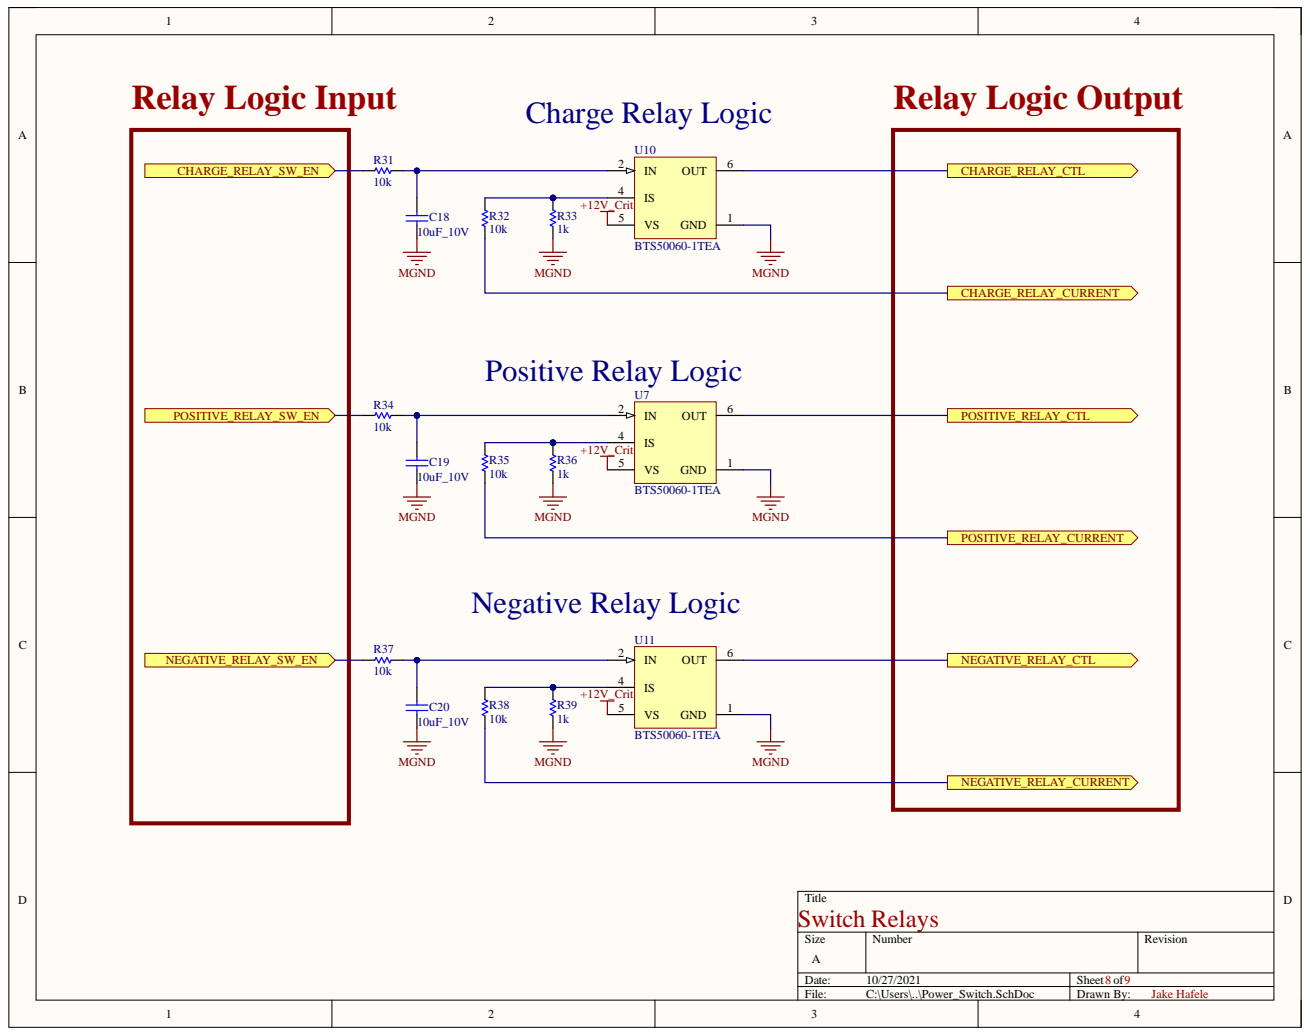
[picture p28: page 7]

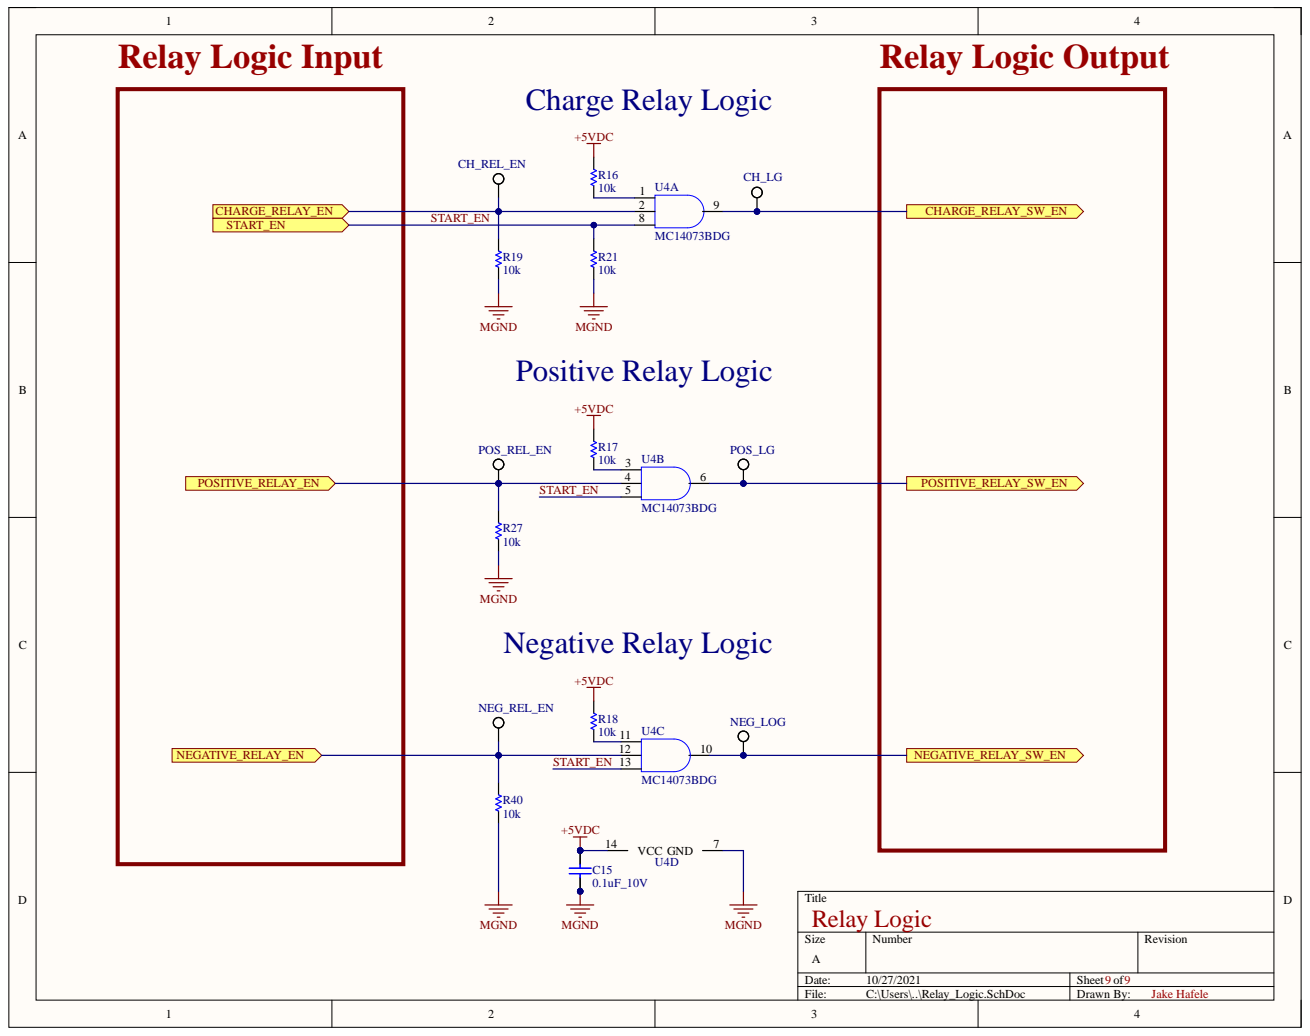
[picture p29: page 8]

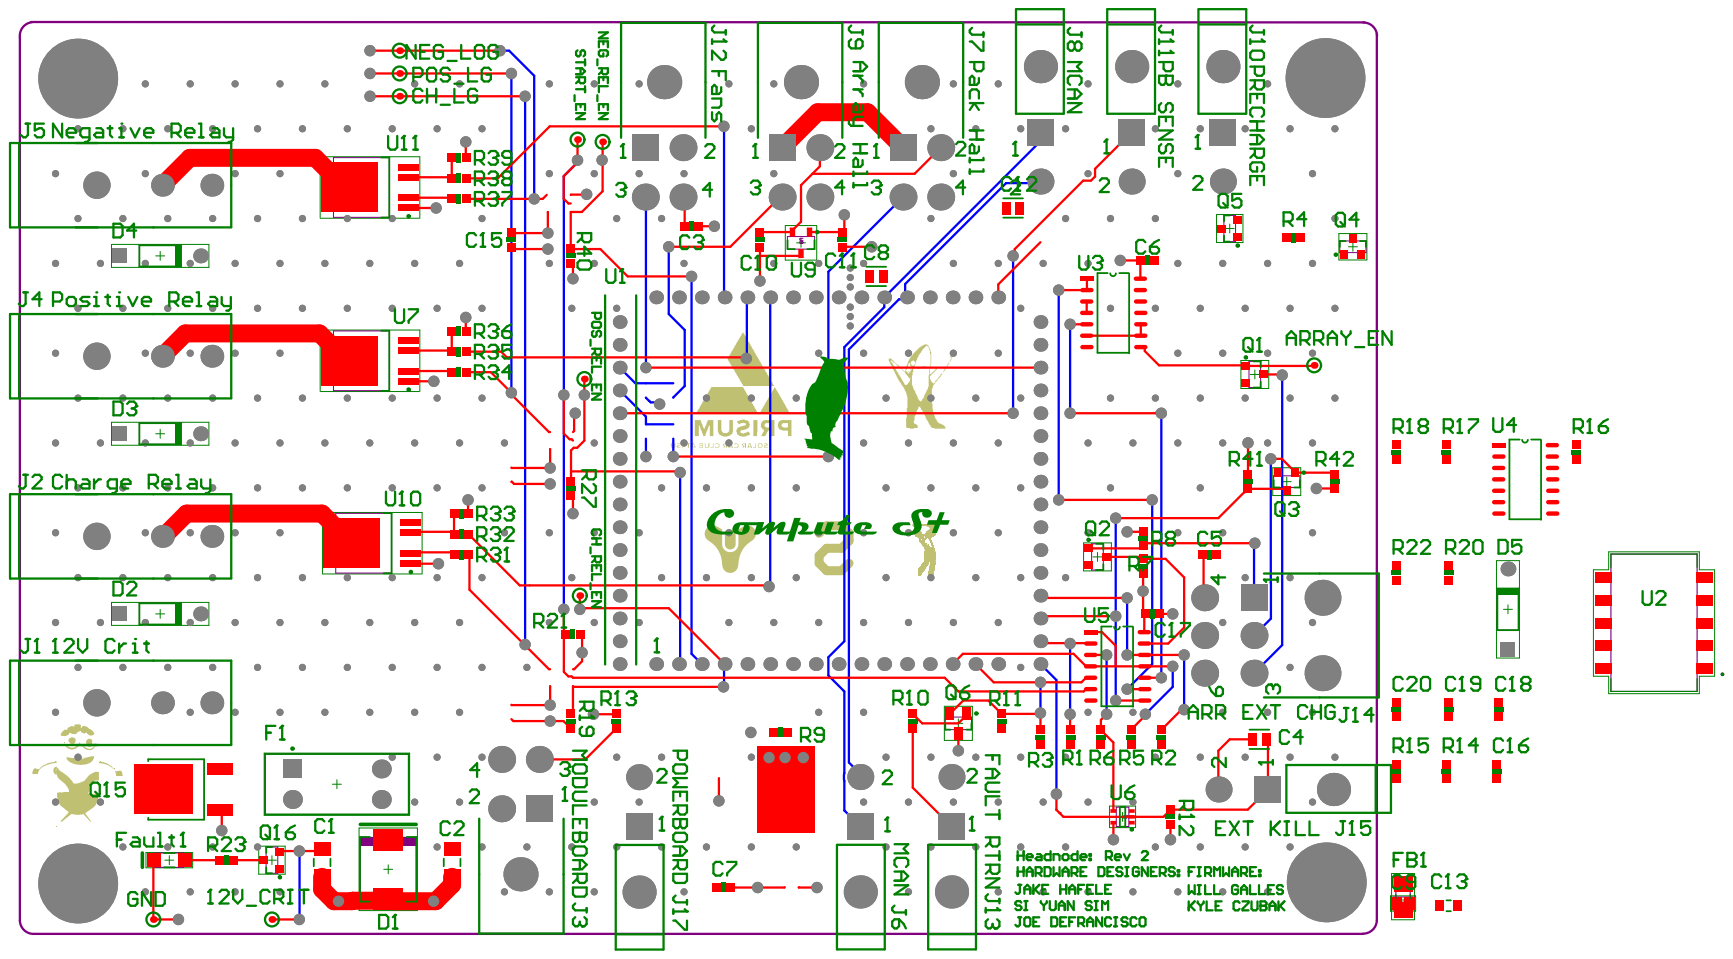
[picture p30: page 9]
