JakeHafele101/Headnode/(list of files, drawings)

Other design files:
Altium Project/Compute.SchDoc
Altium Project/Connector_Exp.SchDoc
Altium Project/Headnode1/Headnode.PcbLib
Altium Project/Headnode1/Headnode.SCHLIB
Altium Project/Headnode.PrjPcb
Altium Project/Interface_exp.SchDoc
Altium Project/Main_Connector.SchDoc
Altium Project/ModuleBoard_Interface.SchDoc
Altium Project/Power_Switch.SchDoc
Altium Project/Regulator.SchDoc
Altium Project/Relay_Logic.SchDoc
